TeunBoekholt/Pigeoff/Final-Presentation.pdf

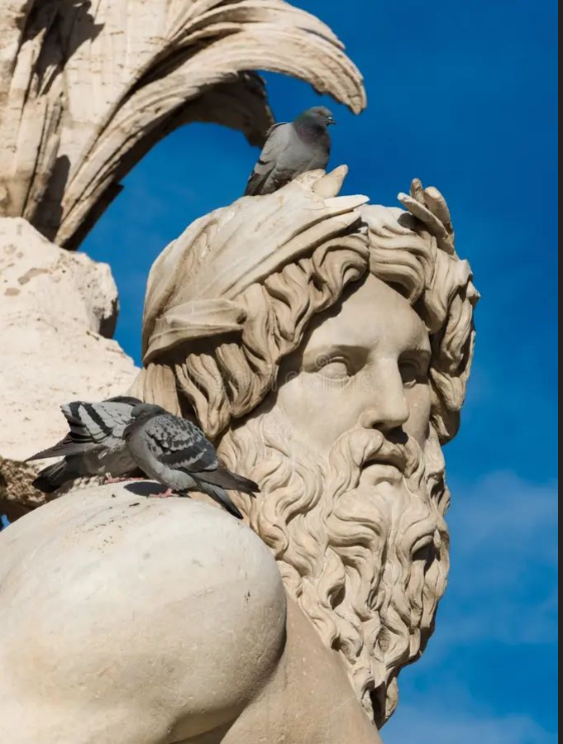
[picture p11: figure]

# PigeOff

Final Presentation

Anja Škrlj - Filippo Zanei - Teun Boekholt

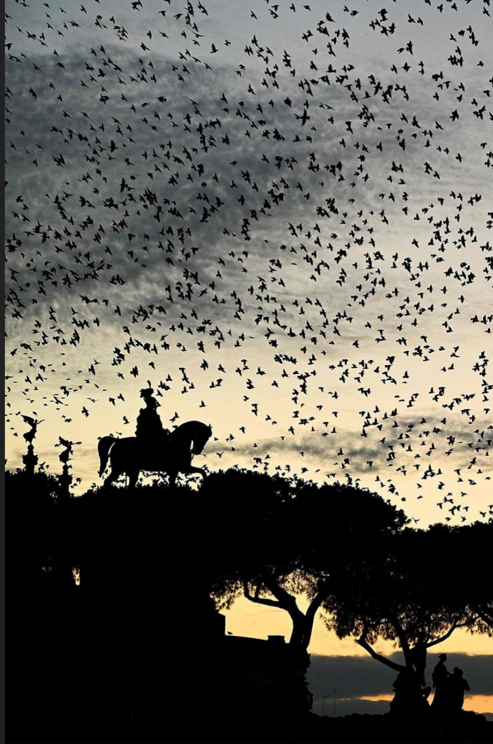
[picture p12: figure]

## Problem Description

- Monuments in Rome get defaced by pigeons
- Existing approaches:
- Nets and spikes
- Urban falconers
- Optical gels
- Map pigeon activity through city

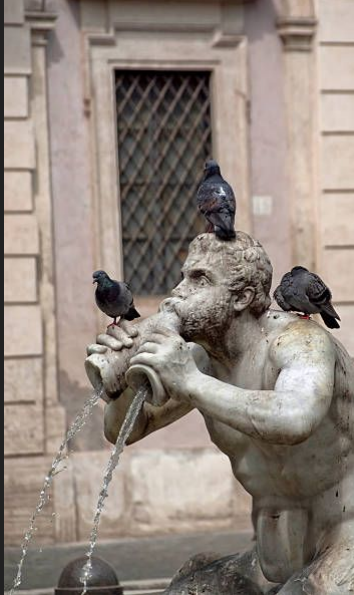
[picture p13: figure]

## Overview

- Pigeon deterrent system
- Radar/Lidar & Cam + LoRa
- Requirements
- 7 day battery life
■ | Feasible maintenance interval for municipality
| services
- 10 second processing time
■ | Pigeon average stay time 16.3 seconds
■ | Defecating happens right before leaving

## Architecture (System)

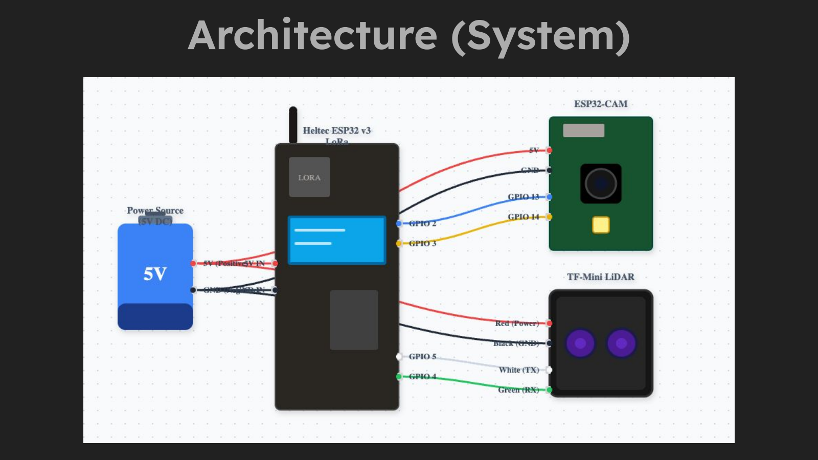
[picture p14: page 4]

## Architecture (FreeRTOS)

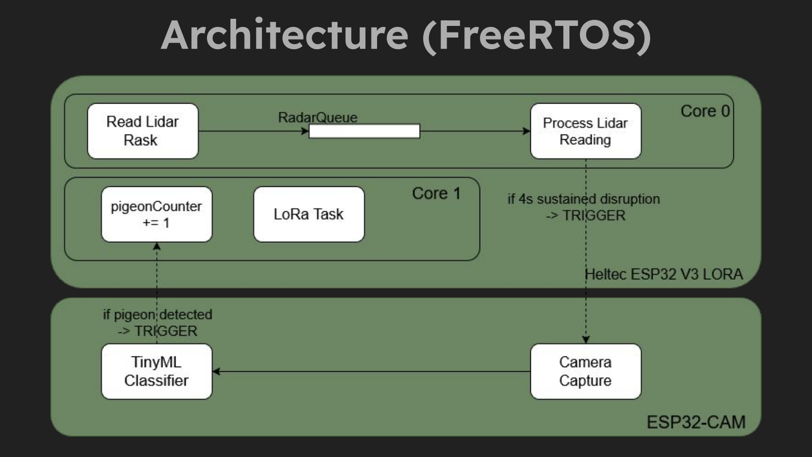
[picture p15: page 5]

## Architecture (FreeRTOS)

- Heltec enters light sleep between LiDAR samples (1s) unless the radio is actively transmitting
- ESP32-Cam in deep sleep unless LoRA board triggers wakeup

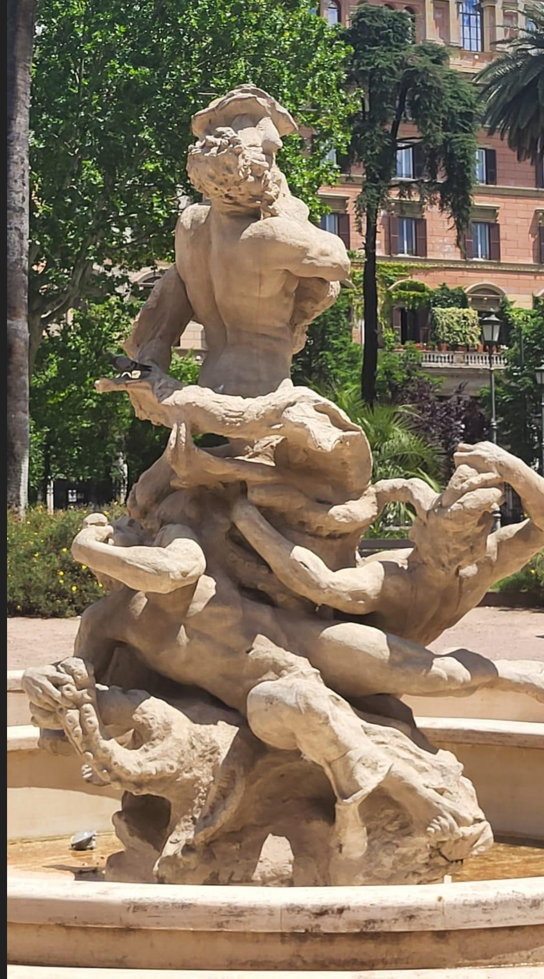
[picture p16: figure]

## Classifier

1. Roboflow (Dataset) + Edge Impulse (MobileNetV1 96x96 0.25)
2. Handcrafted Dataset + Edge Impulse (Handcrafted model)

## Classifier 1

### Dataset size: 1740 – Train/test split: 80/20

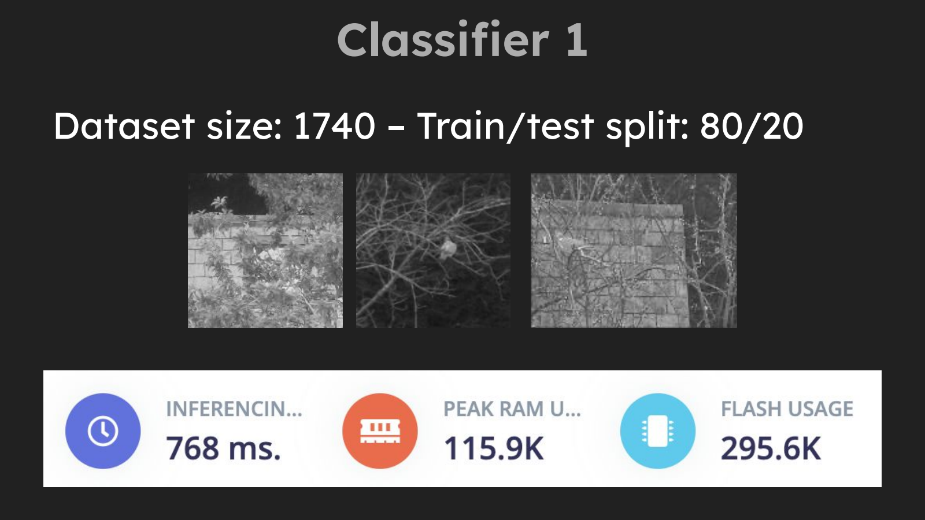
[picture p17: page 8]

## Classifier 2

### Dataset size: 60 – Train/test split: 80/20

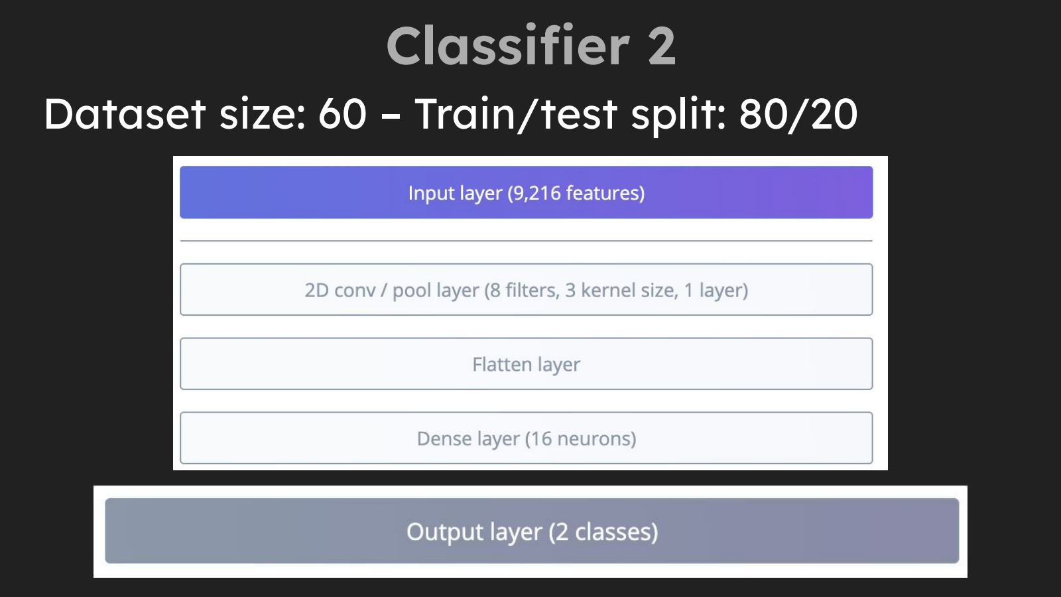
[picture p18: page 9]

## Classifier 2

### Dataset size: 60 – Train/test split: 80/20

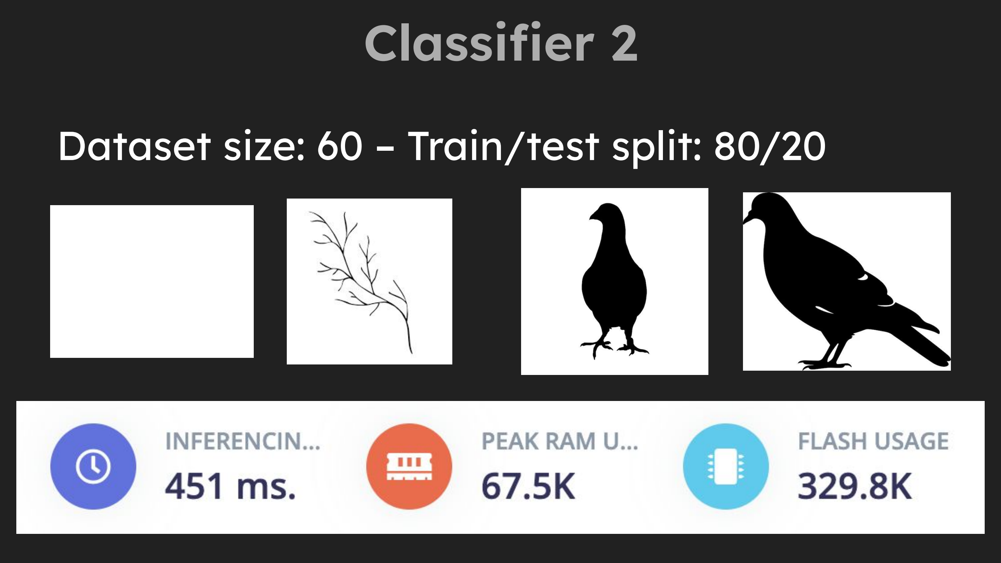
[picture p19: page 10]

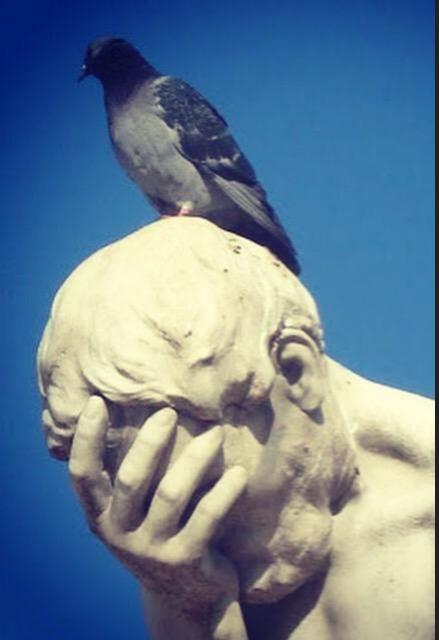
[picture p20: figure]

## LoRa

- Unconfirmed uplinks to
conserve energy
- In current location: SF7
- Pigeon count transmitted every 15 minutes

## LoRa

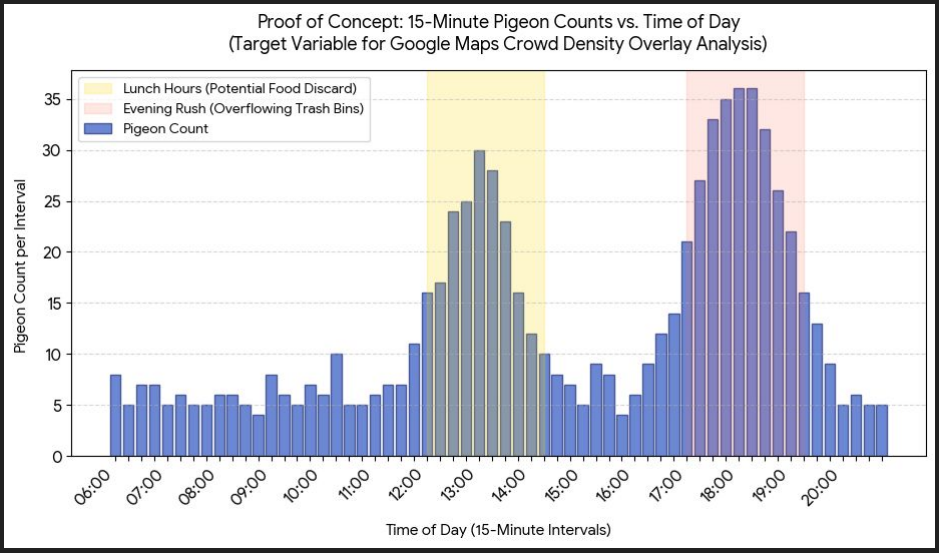
[picture p21: figure]

## Evaluation

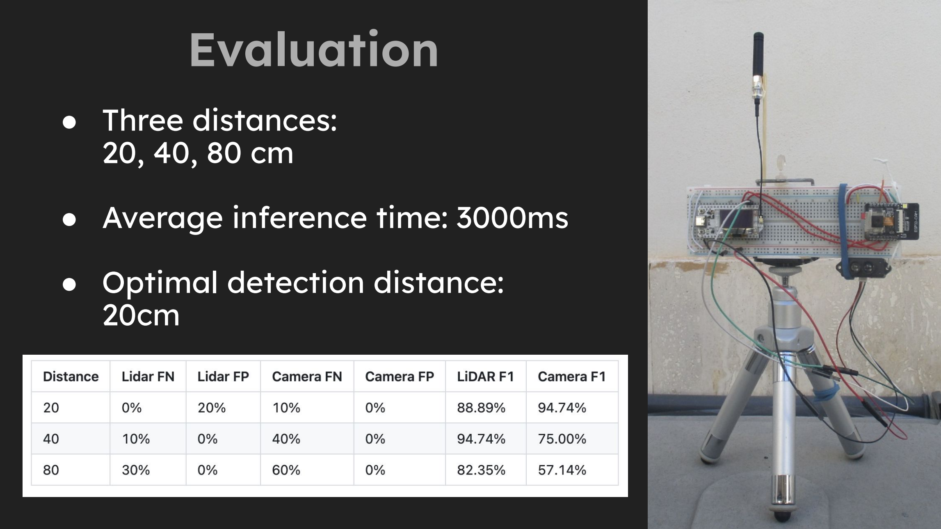
[picture p22: page 13]

- Three distances:
20, 40, 80 cm
- Average inference time: 3000ms
- Optimal detection distance: 20cm

## Energy Evaluation

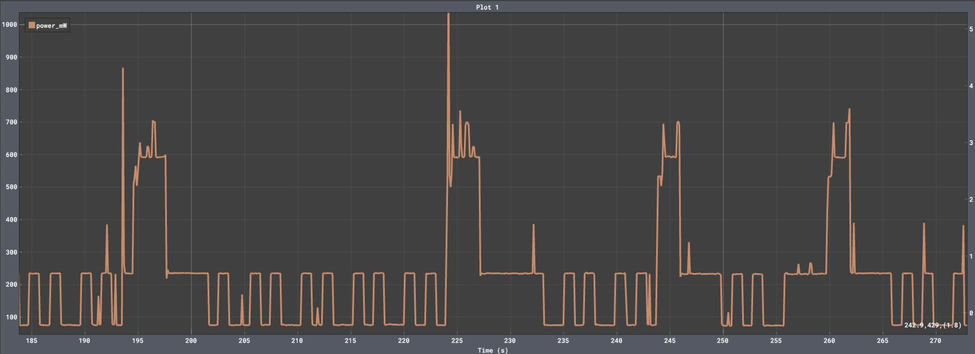
[picture p23: figure]

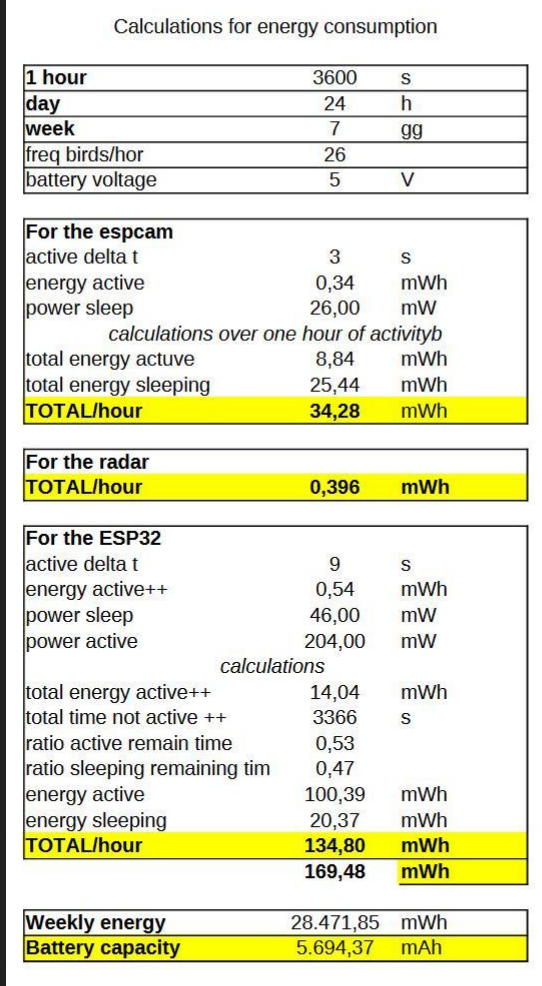
[picture p24: figure]

## Energy Evaluation

- We calculated an upper limit energy consumption
- Generalized as energy per hour
- Using averages from real power measurements
- Theoretical power consumption for the radar

## Energy Evaluation (ESPCAM)

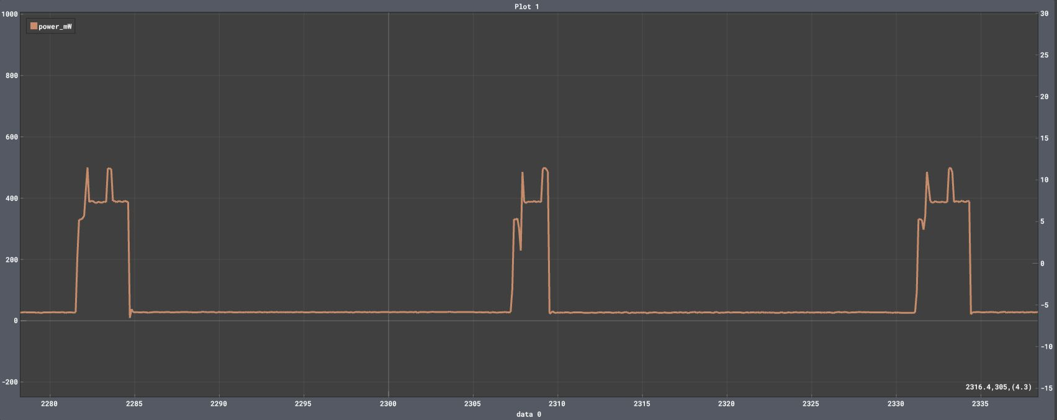
[picture p25: figure]

## Energy Evaluation (ESP32)

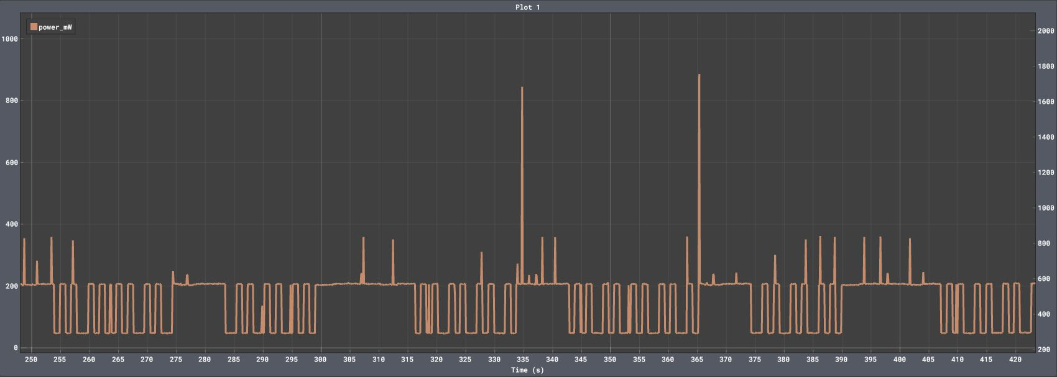
[picture p26: figure]

## Conclusions

- The average time for the inference on the ESPCAM is ∼ 3s
- The average time for the ESP32 to operate is ∼9s (<16s)
- Considering the worst case scenario of living 1 week always in peak activity time, the system can operate with a ∼5700mAh battery

## Further discussion

- Classifier too constrained?
- Better classification -> better features -> edge detection
- Sleeping cycle during inactivity periods (night)
- Implementation of device to scary the pigeons

# DEMO

https://youtu.be/5cjZkr73Wsk
