TeunBoekholt/Pigeoff/PigeOFF_presentation.pdf

# PigeOff

THE Urban Pigeon Deterrent System

Anja Škrlj - Filippo Zanei - Teun Boekholt


# Data

- Infrared/radar (Low-power)
- Mic (High-power)
- Motion detection / camera could also be considered


# Learn & Act

- Learn if a bird is in a
location it shouldn’t
be in
- Deter by playing an
infrasound noise

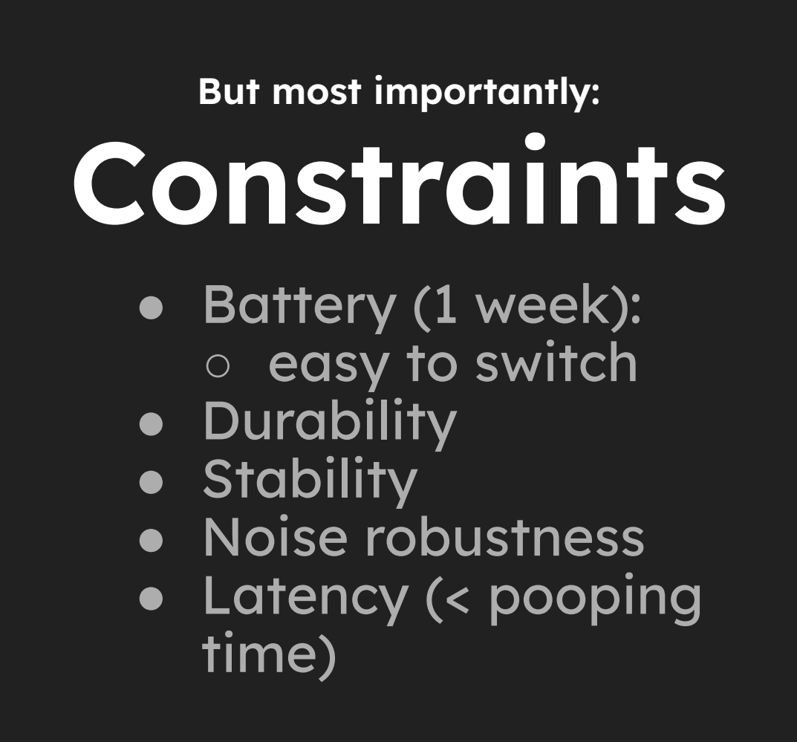
[picture p28: figure]
But most importantly: Constraints; ● Battery (1 week): ○ easy to switch ● Durability ● Stability ● Noise robustness ● Latency (< pooping time)
