TeunBoekholt/Pigeoff/task_structure.png

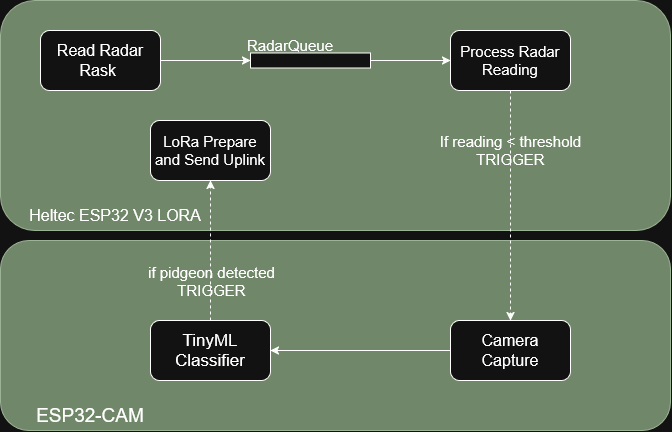
task_structure.png
