TeunBoekholt/Pigeoff/(commit log)

2026-05-17 print update
2026-05-17 pin map
2026-05-21 sleep between samples
2026-05-21 Update board configuration in platformio.ini
2026-05-25 Refactor ESP32-CAM pin handling and camera logic
    Refactor trigger and response pin handling, improve camera initialization and inference process.
2026-05-25 Refactor ESP32-CAM trigger and response logic
2026-05-26 Refactor ESP32-CAM code for improved functionality
2026-05-27 Enhance README with detailed problem and methods sections
    Expanded problem description and existing methods sections to provide more context on pigeon infestation issues and current deterrent methods. Added core documents section for better resource organization.
2026-05-28 lidar sleep
2026-05-28 Document energy consumption and sensor implementation
    Added section on energy consumption and system design choices.
2026-05-28 Update README with energy consumption sections
    Added sections on energy consumption for ESPCam, LiDAR, Heltec ESP32 v3, and radar movement sensor.
2026-05-28 Update README with energy consumption details
    Added sections on energy consumption for LiDAR and Heltec ESP32 v3, including images and explanations.
2026-05-28 Revise energy consumption data in README
    Updated energy consumption values for LiDAR sensor modes.
